hcyang1012/PIC16C57-Verilog/documents/[컴퓨터종합설계][9조][15주차]텀프로젝트최종보고서.pdf

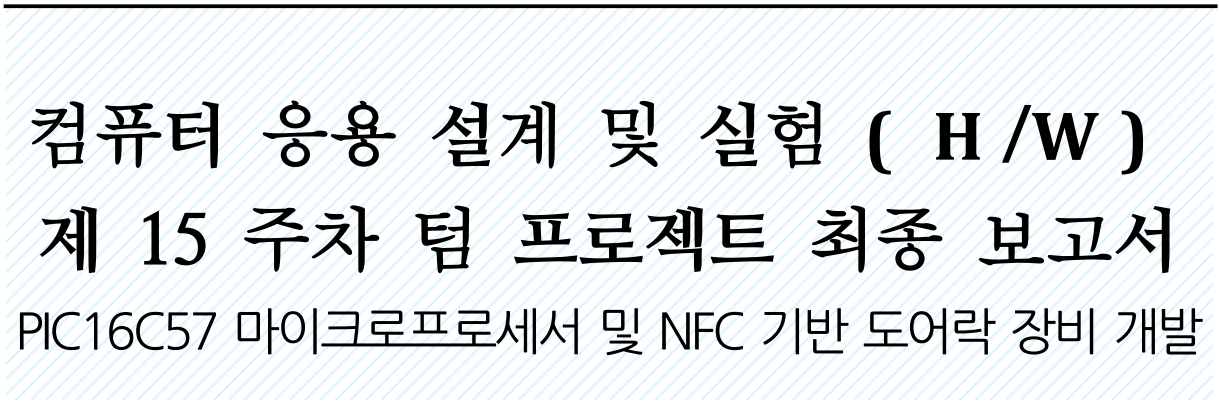
[picture p2: figure]
컴퓨터 응용 설계 및 실험 ( H /W ) 제 15 주차 텀 프로젝트 최종 보고서; PIC16C57 마이크로프로세서 및 NFC 기반 도어락 장비 개발

제출일 | 2012, 12, 18 | 전공 | 정보컴퓨터공학부
과목 | 컴퓨터 응용 설계 및 실험(HW) | 학번 | 200724487 | 200824566
담당교수 | 양 세양 교수님 | 이름 | 양 희철 | 곽 두환

요약

본 텀 프로젝트에서는 PIC16C57에 기반 한 도어락 장비를 개발한다. 이 장비는

비밀번호의 입력을 통한 문을 여닫는 기능, 비밀번호 변경 기능 두 가지를 제공한다.

비밀번호의 입력은 비밀번호가 저장된 NFC 태그를 리더에 인식시키는 방식으로

이루어진다. 비밀번호의 변경은 키패드의 입력을 통해 이루어진다.

이 장비는 크게 FPGA 개발보드, AVR 개발보드, NFC 리더 세가지로 구성되어진

다. FPGA개발보드에는 PIC16C57 마이크로프로세서와 함께 키패드, 모터 제어 모듈이

Verilog HDL로 구현되어 있다. AVR 개발보드는 ATMega128 마이크로프로세서가 장착

되어 있으며, NFC 리더와의 UART 통신 및 FPGA 개발보드와의 통신을 담당한다.

NFC 리더는 비밀번호가 입력된 NFC 태그를 읽어 AVR 개발보드로 전달하는 역할을

담당한다.

### 프로젝트 설명

### 1. 프로젝트 구성

### 1. 전체 구성

Figure 1은 개발한 도어락 장비의 전체 구성을 보여준다.

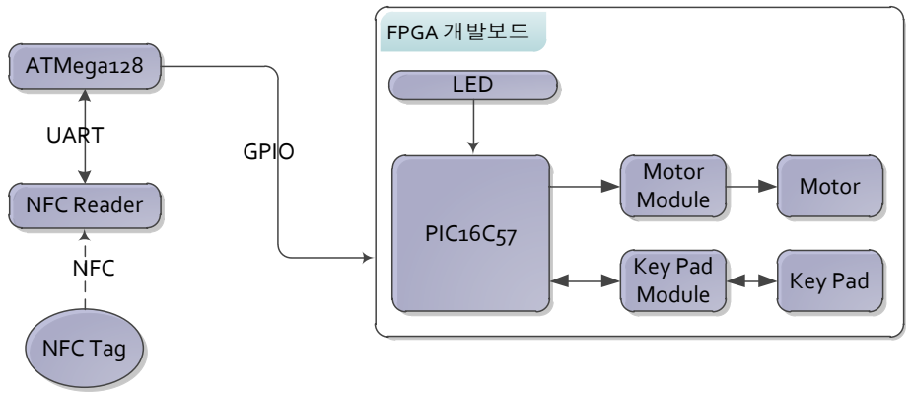
[picture p3: figure]
FPGA; PIC16C57; Motor Module; Key Pad Module; Motor; Key Pad; LED ATMega128; NFC Tag; NFC Reader; GPIO UART; NFC

Fig ure 1 도어락 시스템 구조

### 2. PIC16C57

도어락 프로그램을 수행하는 중심 마이크로프로세서이다. 외부에서 들어오는 입력

을 통해 문을 열거나 비밀번호를 수정하는 기능을 담당한다. 마이크로프로세서는

Verilog HDL로 구현하였고, 도어락 프로그램은 C로 작성하여 PIC의 Program Memory

에 함께 Synthesis하였다.

### 3. 키패드 / 모터 Module

키패드는 변경 할 비밀번호를 입력할 때 사용한다. 키패드 모듈은 이 과정에서 키

패드의 입력을 스캔 한 후 PIC로 전달한다.

모터는 올바른 비밀번호가 입력되었을 경우 동작한다. 모터 제어 모듈은 모터가

돌아 갈 수 있게 동작 신호를 차례로 주는 역할을 한다.

키패드 / 모터 모듈은 Verilog HDL로 작성되었다. 각 모듈은 PIC의 GPIO에 연

결되어 있고, PIC의 도어락 프로그램이 이 모듈들을 제어한다.

### 4. NFC Reader – ATMega128 - FPGA

NFC 리더는 NFC 태그를 읽어내는 역할을 담당한다. 또한 본 텀 프로젝트에서

사용한 NFC 리더는 UART를 통해 외부와 통신을 한다. 하지만 PIC의 경우 UART 기

능이 존재하지 않는다.

때문에 ATMega128은 NFC 리더와 FPGA를 연결하는 역할을 담당한다. NFC 리

더와 ATMega128은 UART통해 연결되어서 NFC 리더가 읽은 태그 정보를 메모리에

저장한다. 또한 ATMega128은 PIC와 GPIO를 통해 연결되어 있다. 이를 통해 이 모듈

은 읽은 NFC 태그에 저장된 비밀번호를 추출 한 후 PIC로 전달한다.

### 5. 시스템 동작

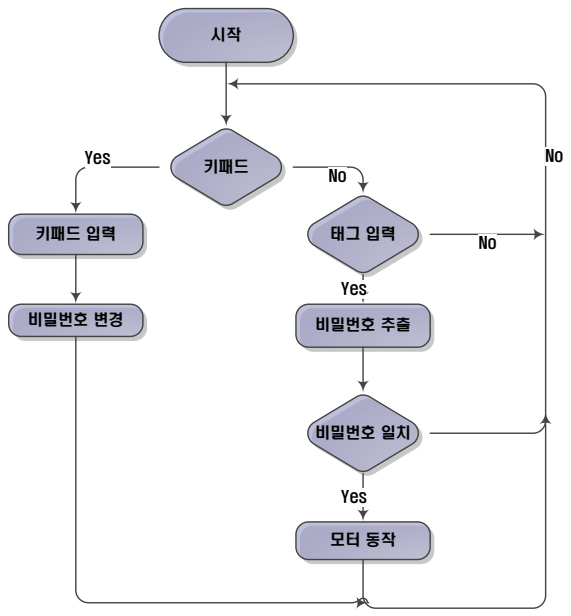
[picture p4: figure]
키패드 키패드 입력; 비밀번호 변경; 비밀번호 추출; 비밀번호 일치; Yes

Fig ure 2 시스템 동작 흐름

Figure 2는 도어락 시스템의 전체적인 동작 흐름을 보여준다. 먼저 키패드 입력이

있을 경우 시스템은 입력 받은 4자리 번호를 비밀번호로 변경한다.

키패드 입력이 없이 태그를 입력이 들어왔을 경우 시스템은 태그에서 비밀번호를

추출 한 후 저장된 비밀번호와 일치한다면 모터를 동작시키고, 일치하지 않으면 모터를

멈추거나 동작시키지 않는다.

### 2. 설계 및 구현

### 1. PIC16C57

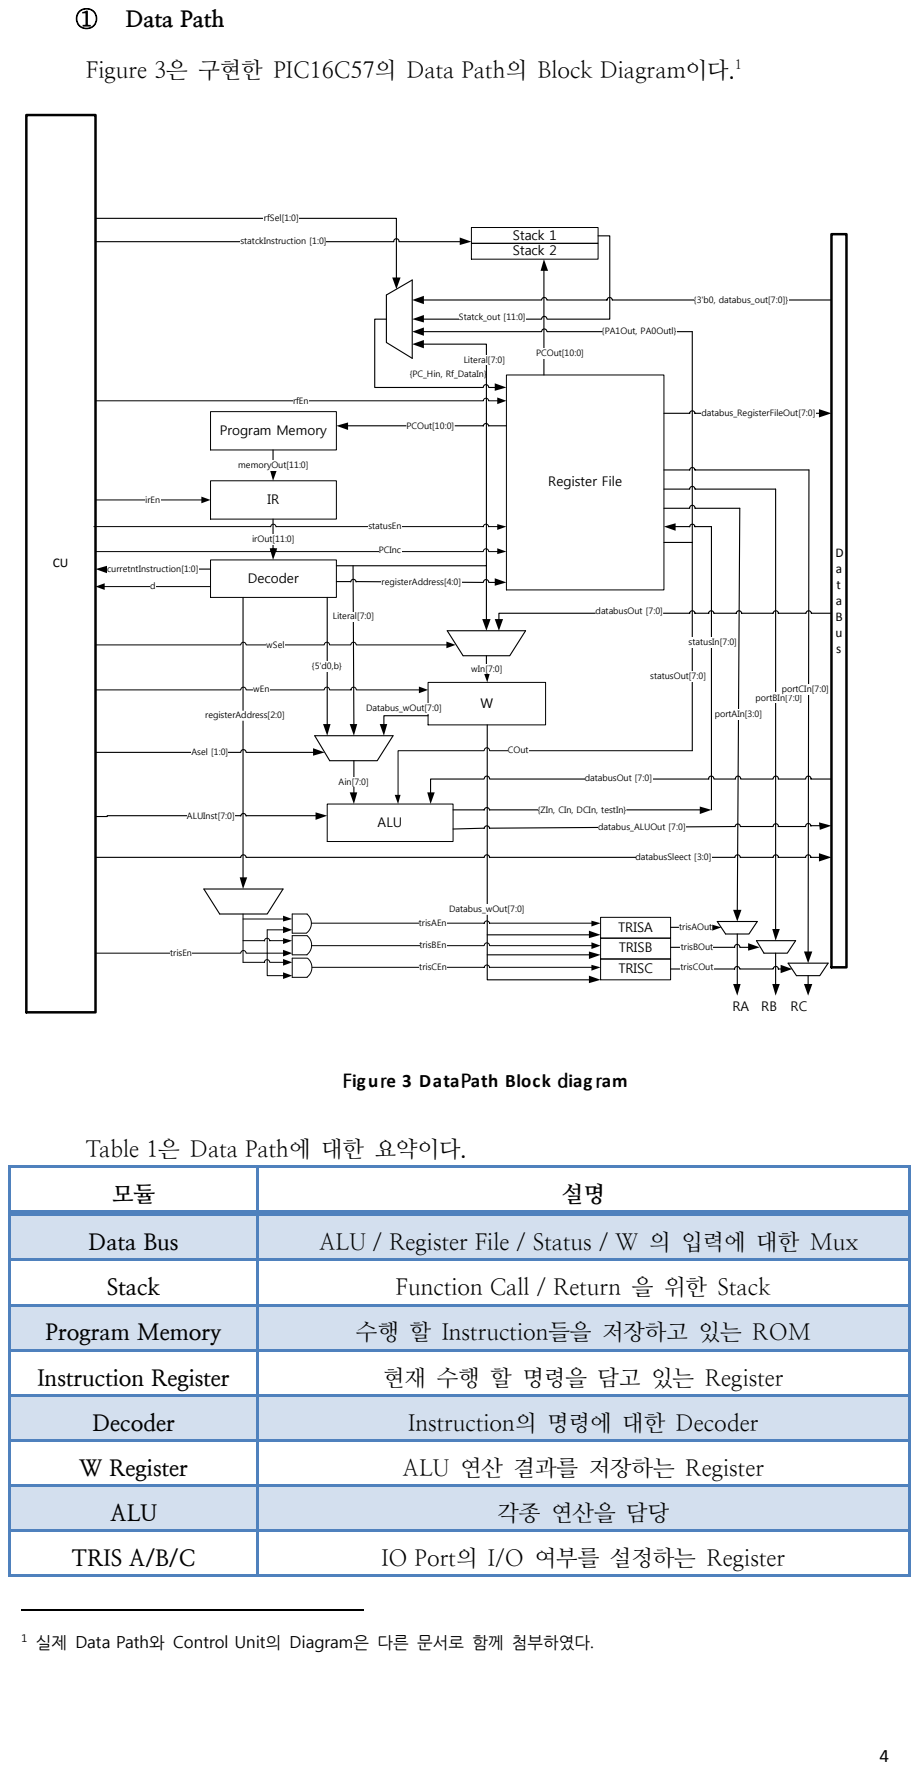
[picture p5: page 4]
Data Path; wEn; rfEn; trisEn; statusEn; rfSel[1:0]; wSel; Asel [1:0]; ALUInst[7:0]; databusSleect [3:0]; statckInstruction [1:0]; Stack 1 Stack 2; {PC_Hin, Rf_DataIn}; PCOut[10:0]; {3'b0, databus_out[7:0]} Statck_out [11:0]; Program Memory; Decoder; memoryOut[11:0]; irOut[11:0]; Literal[7:0]; curretntInstruction[1:0]; registerAddress[4:0] d; Databus_wOut[7:0]; wIn[7:0]; databusOut [7:0] Literal[7:0]; ALU Ain[7:0]; databusOut [7:0] databus_ALUOut [7:0]; statusOut[7:0]; statusIn[7:0]; COut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

Figure 3은 구현한 PIC16C57의 Data Path의 Block Diagram이다.

Register File irEn

{ZIn, CIn, DCIn, testIn}

trisAOut trisBOut trisCOut TRISA TRISB TRISC Databus_wOut[7:0] trisAEn trisBEn

Fig ure 3 DataPath Block diag ram

Table 1은 Data Path에 대한 요약이다.

Data Bus | ALU / Register File / Status / W 의 입력에 대한 Mux

Stack | Function Call / Return 을 위한 Stack

Program Memory | 수행 할 Instruction들을 저장하고 있는 ROM

Instruction Register | 현재 수행 할 명령을 담고 있는 Register

Decoder | Instruction의 명령에 대한 Decoder

W Register | ALU 연산 결과를 저장하는 Register
ALU | 각종 연산을 담당

TRIS A/B/C | IO Port의 I/O 여부를 설정하는 Register

1 실제 Data Path와 Control Unit의 Diagram은 다른 문서로 함께 첨부하였다.

Register File | Data Memory 및 Special Register들을 담고 있는 메모리

Table 1 각 Data Path 모듈 요약

Figure 4는 Data Bus에 대한 Verilog Code이다. 여러 모듈에서 들어오는 입력을

Multiplexing 하는 역할을 담당한다.

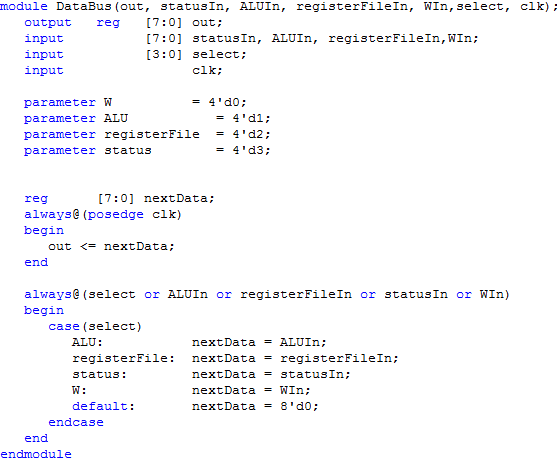
[picture p6: figure]

Fig ure 4 Data Bus Verilog Code

Figure 5는 Stack에 대한 Verilog Code이다. Stack은 Level 1, Level 2 두 레지스터

가 연결되어 있는 형식으로 구현되어 있다. Stack은 Push / Pop 명령을 입력으로 받는데,

각 명령에 따라 Level1, Level2 레지스터들의 데이터 이동이 일어난다.

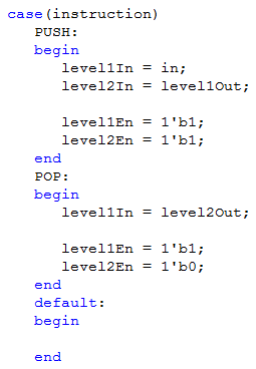
[picture p7: figure]

Fig ure 5 Stack Verilog Code(일부)

Decoder는 Figure 6과 같이 IR로부터 입력 받은 명령을 해석하여 Control Unit으

로 전달하는 역할을 담당한다. 추가로, 각 명령으로부터 Address 등의 여러 Field들도

함께 추출하여 Control Unit이나 Register File 등의 다른 모듈로 전달한다.

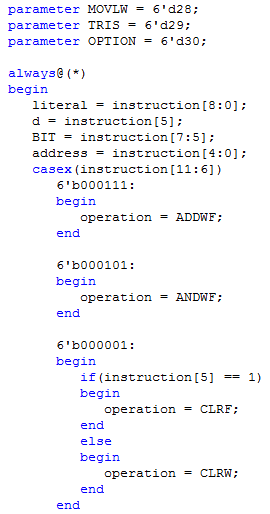
[picture p8: figure]

Fig ure 6 Decoder (일부)

ALU 는 Control Unit으로부터 명령을 입력 받아 그에 대한 연산을 수행한다. 또

한 연산 결과에 따라 Status Register에 입력할 값을 출력한다. Figure 7은 ALU의 구현이

다.

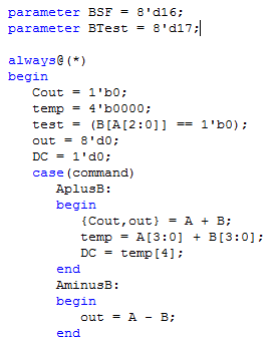
[picture p9: figure]

Fig ure 7 ALU 구현(일부)

Register File은 Data Memory 및 Special Register의 집합이다. 기본적으로는

Figure 8과 같이 입력한 Address에 대한 Read / Write 작업을 수행한다.

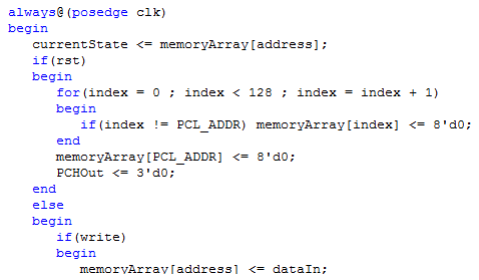
[picture p10: figure]

Fig ure 8 Reg ister File – Write 작업

Register File은 Figure 9와 같이 Special Register에 대한 작업도 함께 담당한다.

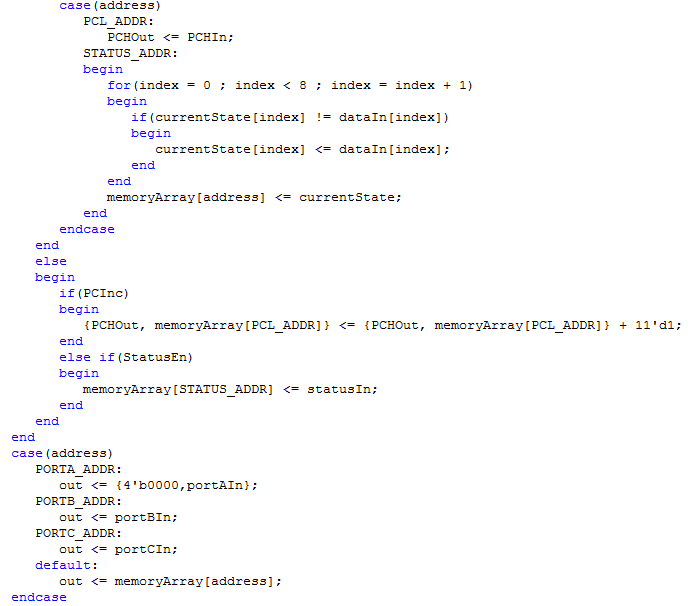
[picture p11: figure]

Fig ure 9 Reg ister File - Special Reg ister 작업

마지막으로 Register File은 Figure 10과 같이 Indirect Addressing에 대한 처리도

수행한다.

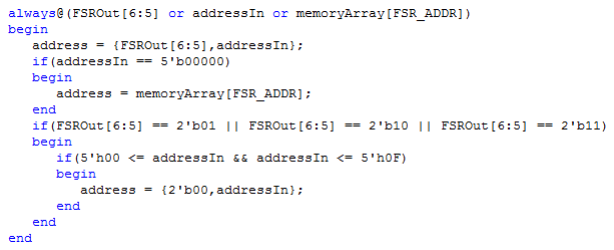
[picture p12: figure]

Fig ure 10 Reg ister File - Indirect Addressing

② Control Unit

Figure 11은 구현한 PIC16C57의 Control Unit 의 ASM Chart이다.

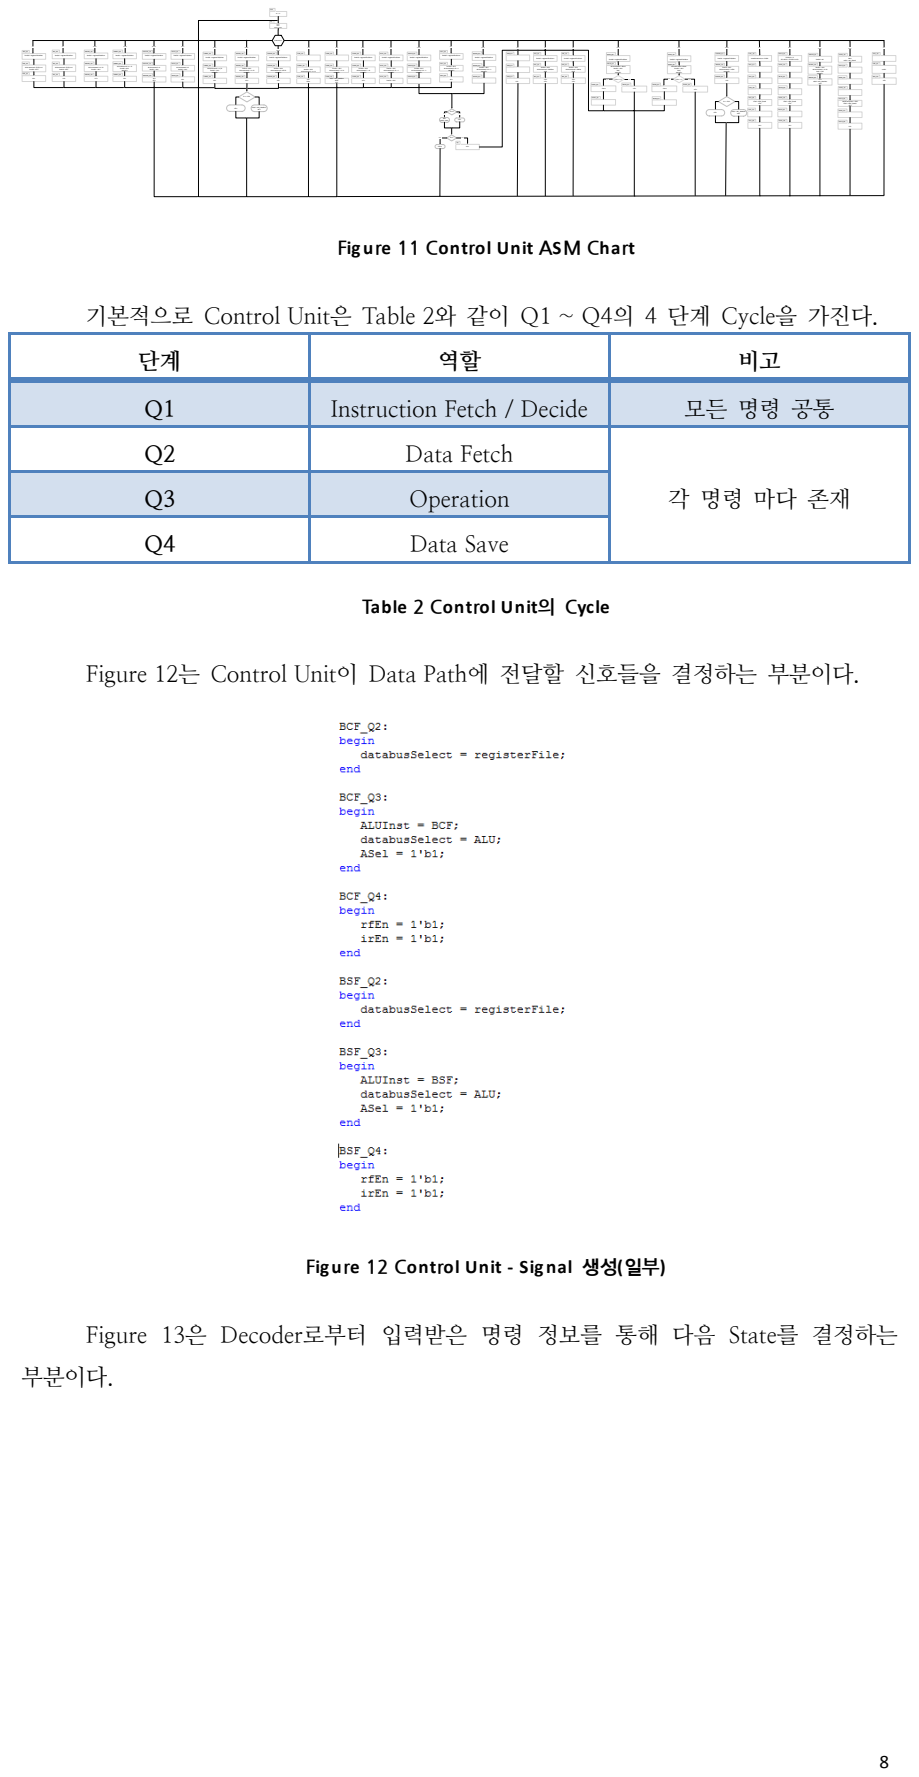
[picture p13: page 8]
PC <- 0 IDLE; RRF_Q2; RRF_Q4; BCF_Q2; BCF_Q3; BCF_Q4; BSF_Q2; BSF_Q3; BSF_Q4; BTFSC_Q2; BTFSC_Q4; BTFSC_Q5; BTFSS_Q2; BTFSS_Q4; BTFSS_Q5; ANDWF_Q2; ANDWF_Q3; ANDWF_Q4; CALL_Q2; CALL_Q3; CALL_Q4; CALL_Q5; CALL_Q6; CALL_Q7; CALL_Q8; GOTO_Q3; GOTO_Q4; GOTO_Q5; GOTO_Q6; GOTO_Q7; GOTO_Q8; XORLW_Q2; GOTO_Q2; TRIS_Q2; TRIS_Q3; TRIS_Q4; Instruction; True; d==0 wEn WSel = WIn; rfEn True; MOVWF_Q2; MOVWF_Q4; busSel = registerFileSelect; irEn rfEn; MOVF_Q2; MOVF_Q4; irEn; IORWF_Q2; IORWF_Q4; RLF_Q2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

Ren PCen PCse = incPC Q1

GOTO_Q2
PC<8:0> = k PC<10:9> = STATUS <6:5>

RRF_Q3
ALUcommand= {C,B}>>>1 busSel = ALU

RLF_Q3
ALUcommand= {C,B}<<<1 busSel = ALU

XORWF_Q3
ALUcommand = A ^ B busSel = ALU

SUBWF_Q3
ALUcommand = A – B busSel = ALU statusEn

MOVWF_Q3
ALUcommand = A busSel = ALU

MOVF_Q3
ALUcommand = B busSel = ALU

IORWF_Q3
ALUcommand = A | B busSel = ALU statusEn

ADDWF_Q3
busSel = ALU ALUcommand = A + B statusEn

ANDWF_Q3
busSel = ALU ALUcommand = A & B statusEn

CLRWF_Q3
busSel = ALU ALUcommand = A ^ A

CLRW_Q3
busSel = ALU ALUcommand = A ^ A statusEn wSel = wIn_databus Wen irEn

COMF_Q3
busSel = ALU ALUcommand = ~ B statusEn

DECF_Q3
busSel = ALU ALUcommand = B – 1 statusEn

DECFSZ_Q3

INCF_Q3
busSel = ALU ALUcommand = B + 1 statusEn

INCSFZ_Q3

busSel = registerFileSelect busSel = ALU ALUcommand = BitClear ASel

busSel = registerFileSelect busSel = ALU ALUcommand = BitSet ASel

BTFSC_Q3
ALUcommand = Btest busSel = ALU Asel statusEn

BTFSS_Q3

busSel = registerFileSelect busSel = ALU ALUcommand = A & B statusEn

XORLW_Q3
busSel = ALU ALUcommand = A ^ B Asel = 2'd2 statusEn

XORLW_Q4
irEn wSel = wIn_databus wEn

GOTO_Q6
stackInstruction = POP rfSel = rfSel_Statck rfEn

Fig ure 11 Control Unit ASM Chart

기본적으로 Control Unit은 Table 2와 같이 Q1 ~ Q4의 4 단계 Cycle을 가진다.

Q1 | Instruction Fetch / Decide | 모든 명령 공통

Q2 | Data Fetch | 각 명령 마다 존재

Q3 | Operation

Q4 | Data Save

Table 2 Control Unit의 Cycle

Figure 12는 Control Unit이 Data Path에 전달할 신호들을 결정하는 부분이다.

Fig ure 12 Control Unit - Sig nal 생성(일부)

Figure 13은 Decoder로부터 입력받은 명령 정보를 통해 다음 State를 결정하는
부분이다.

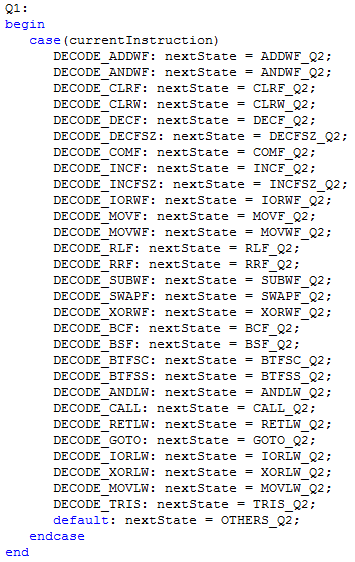
[picture p14: figure]

Fig ure 13 Control Unit - Next State 결정

### 2. 키패드 / 모터 Module

4 * 3 개의 키를 가지고 있는 키 패드는 각 열을 차례로 스캔하면서 눌러진 키를

알아내는 방식으로 동작한다. Table 3은 각 스캔별로 인식하게 되는 키를 나타낸다.

열 | 행 | 입력된 키
1 | 1000 | 1
| 0100 | 4
| 0010 | 7
| 0001 | *
2 | 1000 | 2
| 0100 | 5
| 0010 | 8
| 0001 | 0
3 | 1000 | 3
| 0100 | 6
| 0010 | 9
| 0001 | #

Table 3 키패드 스캔 별 키 값

키패드 모듈은 Table 3에 따라 키패드를 스캔하면서 값을 인식하는 State

Machine이다. Figure 14는 키패드 모듈에서의 State 이동을 수행하는 Verilog 코드이다.

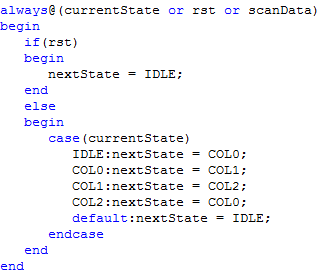
[picture p15: figure]

Fig ure 14 키패드 모듈의 State

Figure 15는 각 상태 별로 입력된 키를 판별하는 Verilog Code이다.

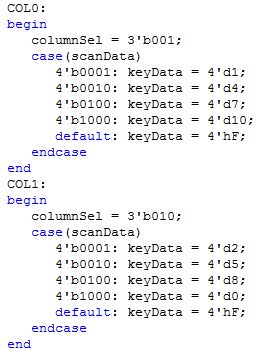
[picture p16: figure]

Fig ure 15 각 상태 별 키 인식(일부)

스텝 모터는 Table 4와 같이 각 상태별로 다른 값을 차례로 입력시키면 동작하게

된다.

입력

| 상태
State 1 | State 2 | State 3 | State 4
A | 1 | 0 | 0 | 0
B | 0 | 1 | 0 | 0
/A | 0 | 0 | 1 | 0
/B | 0 | 0 | 0 | 1

Table 4 스텝 모터 입력

모터 모듈은 Table 4에 맞추어서 만든 State Machine이다. Figure 16은 모터 모듈

의 State 전환을 담당하는 Verilog 코드이다.

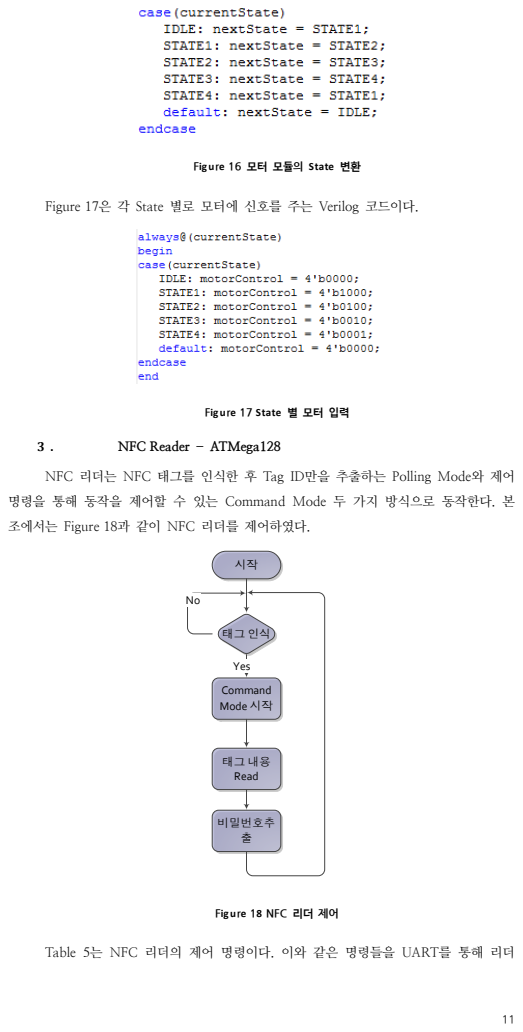
[picture p17: page 11]
3. NFC Reader – ATMega128; 비밀번호추 출; Yes

Fig ure 16 모터 모듈의 State 변환

Figure 17은 각 State 별로 모터에 신호를 주는 Verilog 코드이다.

Fig ure 17 State 별 모터 입력

NFC 리더는 NFC 태그를 인식한 후 Tag ID만을 추출하는 Polling Mode와 제어
명령을 통해 동작을 제어할 수 있는 Command Mode 두 가지 방식으로 동작한다. 본
조에서는 Figure 18과 같이 NFC 리더를 제어하였다.

Command Mode 시작

태그 내용 Read

Fig ure 18 NFC 리더 제어

Table 5는 NFC 리더의 제어 명령이다. 이와 같은 명령들을 UART를 통해 리더

에 전달하면 그에 해당하는 동작을 실행 할 수 있게 된다.

Byte Format | 비고
0xAA,0x00,0x01,0x00,0x01,0xFF | Command Mode 시작
0xAA,0x00,0x02,0x00,0x02,0xFF | Command Mode 종료
0xAA,0x05,0x01,0x00,0x04,0xFF | Tag ID Read
0xAA,0x05,0x02,0x02,0x30,0x07,0x32,0xFF | Tag Block Read

Table 5 NFC 리더 명령

Figure 19는 Table 5의 명령들을 NFC 리더로 전달하고 그 응답신호를 읽는 코드

의 일부이다. 이 코드들은 내부적으로 UART를 통해 동작을 한다. 이 코드를 수행하고

난 후에는 메모리에 태그에서 추출 한 비밀번호가 저장된다.

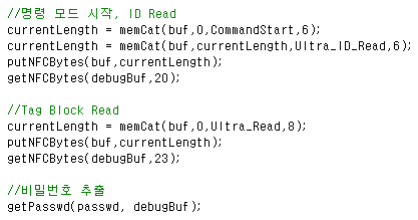
[picture p18: figure]

Fig ure 19 NFC 리더 명령 코드(일부)

### 4. ATMeag128 – PIC16C57

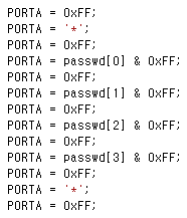
[picture p19: figure]

Fig ure 20 비밀번호 전달

Figure 20은 추출한 비밀번호를 PIC로 전달하는 코드이다. FPGA와 ATMega128

은 단순히 GPIO를 통해 연결되어 있기 때문에 GPIO Port에 데이터만 입력하면 비밀번

호의 전달이 가능하다.

한편, 이 PIC에서 동작하는 도어락 프로그램은 ‘*’를 입력하면 비밀번호 입력 및

비교를 시작하도록 정의해 놓았다. 그렇기 때문에 비밀번호를 입력하기 전과 후에 ‘*’

문자를 넣어 주었다. 또한 각 입력 사이에는 다른 값이 들어간다는 신호로 0xFF를 주

었다.

### 5. 결과물 실행 방법

Figure 21은 구현한 시스템의 전체 구성을 보여준다.

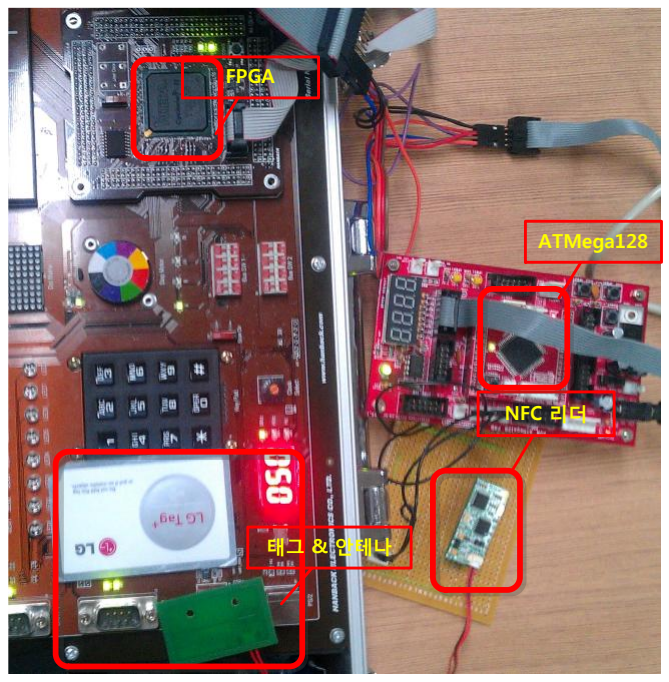
[picture p20: figure]
NFC 리더; ATMega128; 태그 & 안테나; FPGA

Fig ure 21 구현한 시스템 전체 구성

Figure 22는 안드로이드 스마트폰을 이용해서 NFC 태그에 비밀번호를 입력한 화

면이다.

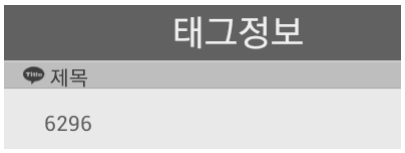
[picture p21: figure]

Fig ure 22 비밀번호를 입력 한 태그

Figure 21과 같이 구성한 후 안테나에 비밀번호가 입력된 태그를 인식시키면 비밀

번호가 맞을 경우 Figure 23과 같이 LED가 켜짐과 함께 모터가 동작한다.

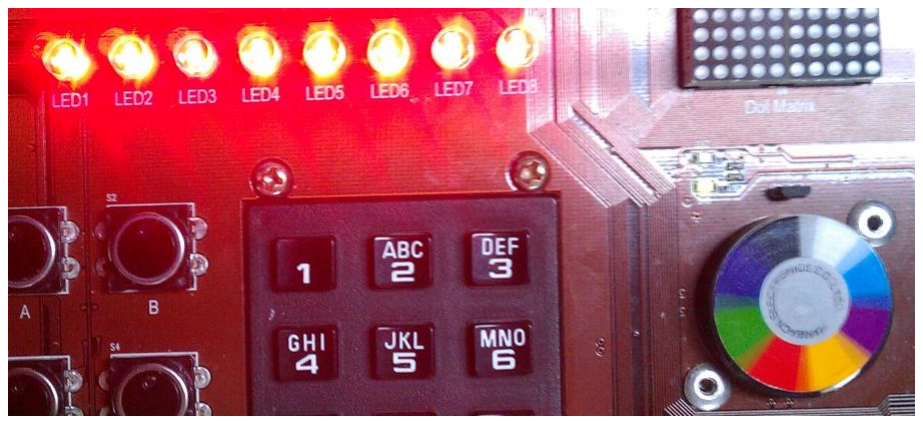
[picture p22: figure]

Fig ure 23 비밀번호를 제대로 입력하였을 경우

키패드는 비밀번호를 변경하기 위해 사용된다. ‘*” – 비밀번호 4자리 = ‘*’ 순으

로 입력하면 비밀번호가 변경되며, 이후에는 태그에 변경된 비밀번호를 저장하여야 한다.

결론

본 과목에서는 Verilog HDL을 이용해서 PIC16C57 마이크로프로세서를 설계 및

검증하는 것을 배웠다. 또한 구현한 PIC를 이용해 하나의 시스템을 직접 설계 및 구현

하는 것을 텀 프로젝트로 수행하였다. 본 조에서는 간단한 도어락 시스템을 구현하였다.

텀 프로젝트를 수행하는 과정에서 지난 4년 동안 배운 전공 지식을 모두 사용 할

수 있었다. 전기회로 시간에 배웠던 지식을 바탕으로 시스템의 회로를 구성 하였고, C

언어를 이용해서 PIC 및 ATMega128에서 동작하는 Firmware를 구현하였다. 그리고 데

이터 통신 및 컴퓨터 네트워크 시간에 배웠던 지식을 기반으로 NFC 및 UART 통신을

구현 할 수 있었으며 이 과정에서 두 시스템 간의 프로토콜 설계 경험도 할 수 있었다.

또한 논리설계, 시스템 소프트웨어, 컴퓨터 구조, 임베디드 시스템, VLSI 시스템

설계 등의 과목에서 배웠던 지식을 총망라 하여 PIC라는 상용 마이크로프로세서를 설계

할 수 있었다.

결국 이 과목의 텀 프로젝트는 회로 단계의 가장 밑바닥부터 실제 동작하는 응용

프로그램까지 전체 시스템을 모두 설계 한 결과이다. 비록 실제 결과물은 크지 않았지만

쉽게 접할 수 없는 경험을 할 수 있는 기회가 되었다고 생각한다.

## 첨부 문서

파일 / 디렉토리 명 | 내용
[컴퓨터종합설계][9조][15주차]텀프로젝트최종보고서.pdf | 최종 보고서
Signal_table.pdf | Signal Table
CU_DP.pdf | Control Unit / Data Path Diagram
ATMega128.tar.bz | ATMega128 Source Code
PIC16C57.zip | PIC16C57 Source Code
