hcyang1012/PIC16C57-Verilog/documents/CU_DP.pdf

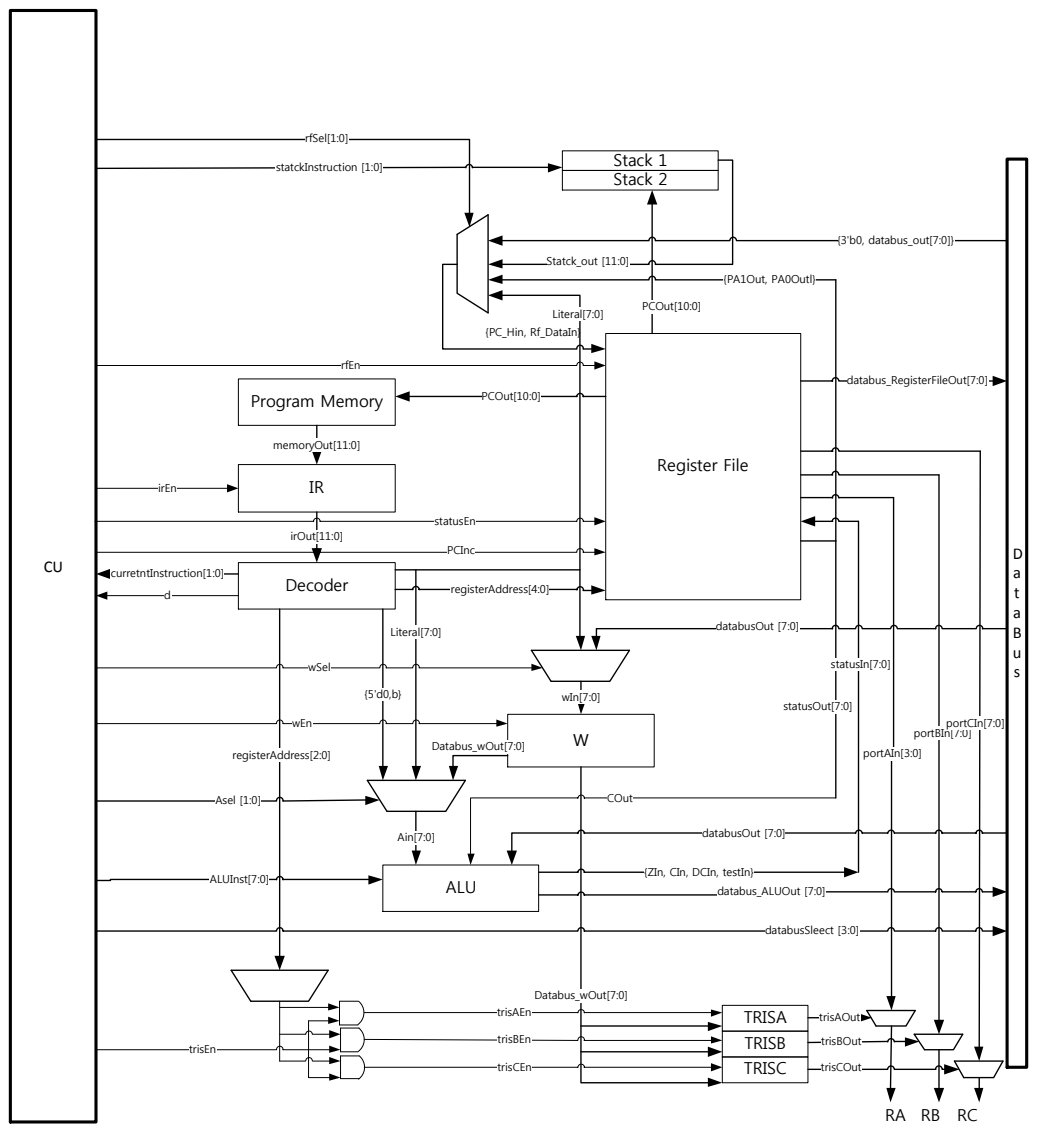
[picture p23: page 1]
Register File; irEn; wEn; rfEn; trisEn; statusEn; rfSel[1:0]; wSel; Asel [1:0]; ALUInst[7:0]; databusSleect [3:0]; statckInstruction [1:0]; Stack 1; Stack 2; {PC_Hin, Rf_DataIn}; PCOut[10:0]; {3'b0, databus_out[7:0]}; Statck_out [11:0]; Program Memory; Decoder; memoryOut[11:0]; irOut[11:0]; Literal[7:0]; curretntInstruction[1:0]; registerAddress[4:0] d; Databus_wOut[7:0]; wIn[7:0]; databusOut [7:0] Literal[7:0]; ALU; Ain[7:0]; databusOut [7:0]; databus_ALUOut [7:0]; statusOut[7:0]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

{ZIn, CIn, DCIn, testIn}

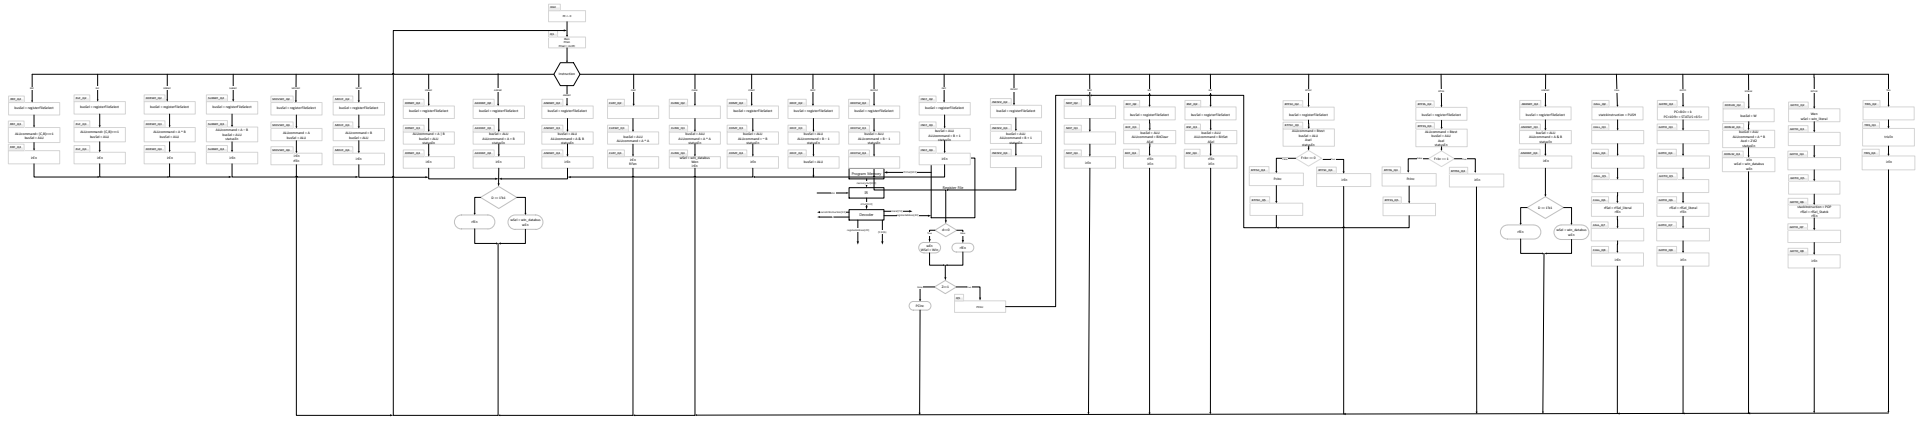
[picture p24: page 2]
Register File; irEn; Program Memory; Decoder; memoryOut[11:0]; irOut[11:0]; PCOut[10:0]; Literal[7:0] curretntInstruction[1:0]; registerAddress[4:0] d; {5'd0,b} registerAddress[2:0]; IDLE; IRen PCen PCsel = incPC; Instruction; True; wEn WSel = WIn; rfEn; False; MOVWF_Q2; MOVWF_Q3; MOVWF_Q4; busSel = registerFileSelect; ALUcommand = A busSel = ALU; irEn rfEn; MOVF_Q2; MOVF_Q3; MOVF_Q4; ALUcommand = B busSel = ALU; IORWF_Q2; IORWF_Q3; IORWF_Q4; ALUcommand = A | B busSel = ALU statusEn; RRF_Q2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
